zoraizmahmood/Consola-1602-v2/assets/pcb-bottom.png

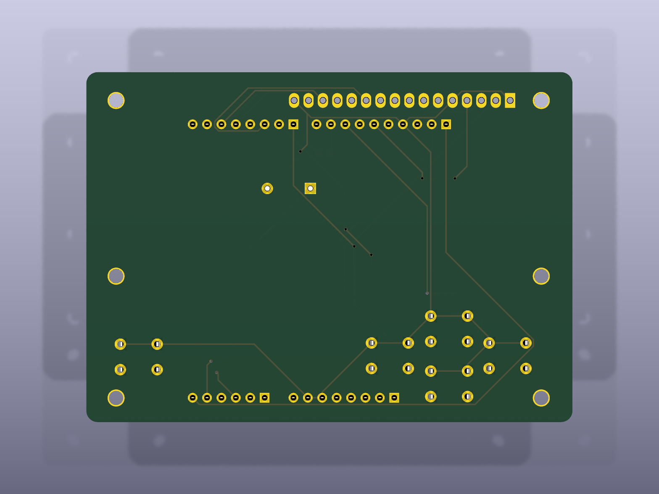
assets/pcb-bottom.png
