zoraizmahmood/Consola-1602-v2/assets/pcb-top.png

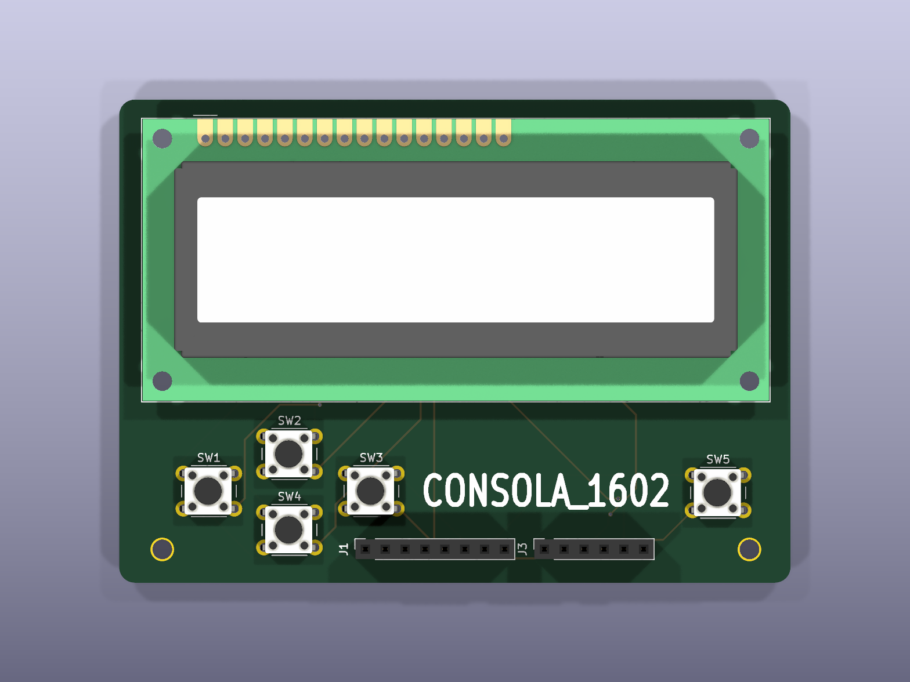
assets/pcb-top.png
