zoraizmahmood/Consola-1602-v2/hardware/carcasa/carcasa-v2.step

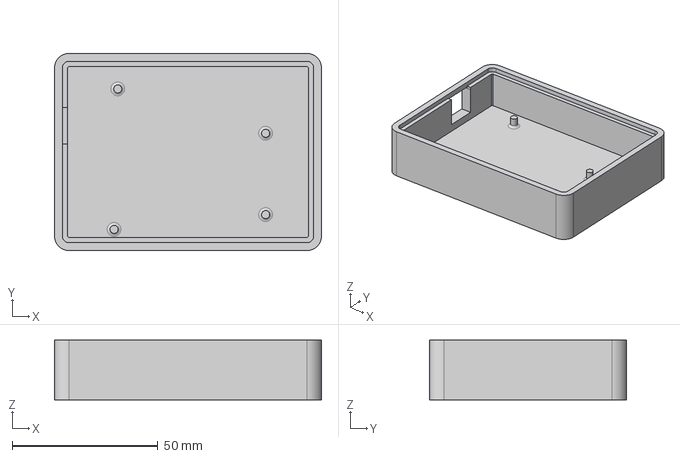
[picture p9: CAD file, 2026-11-06]
hardware/carcasa/carcasa-v2.step
91.7 x 67.8 x 20.6 mm
