zoraizmahmood/Consola-1602-v2/(list of files, cad)

Other CAD files:
hardware/carcasa/carcasa-v2.3mf
