zoraizmahmood/Consola-1602-v2/assets/esquema.pdf

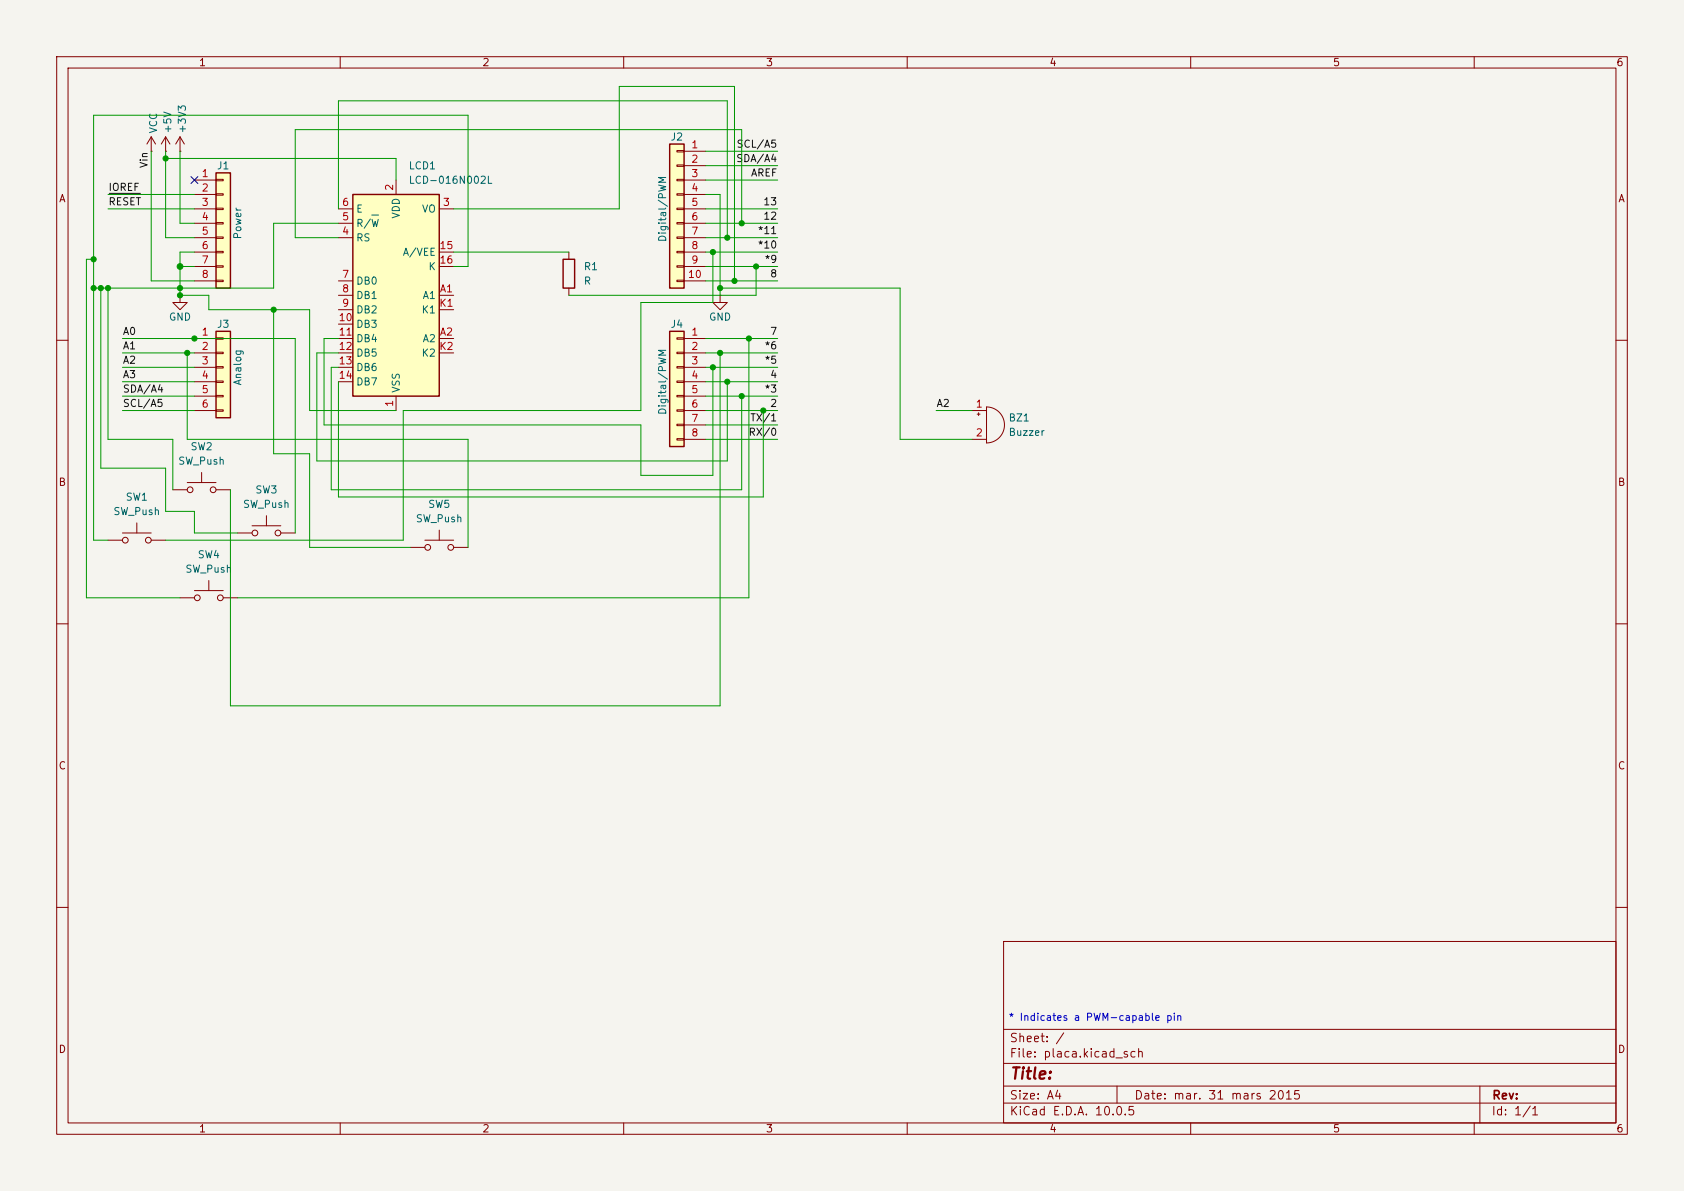
[picture p10: page 1]

* Indicates a PWM-capable pin
Sheet: /
File: placa.kicad_sch
Title:

Size: A4 | Rev:
KiCad E.D.A. 10.0.5 | Id: 1/1
