zoraizmahmood/Consola-1602-v2/hardware/pcb/placa.kicad_pcb

## KiCad design hardware/pcb/placa.kicad_pcb (2026-11-06)

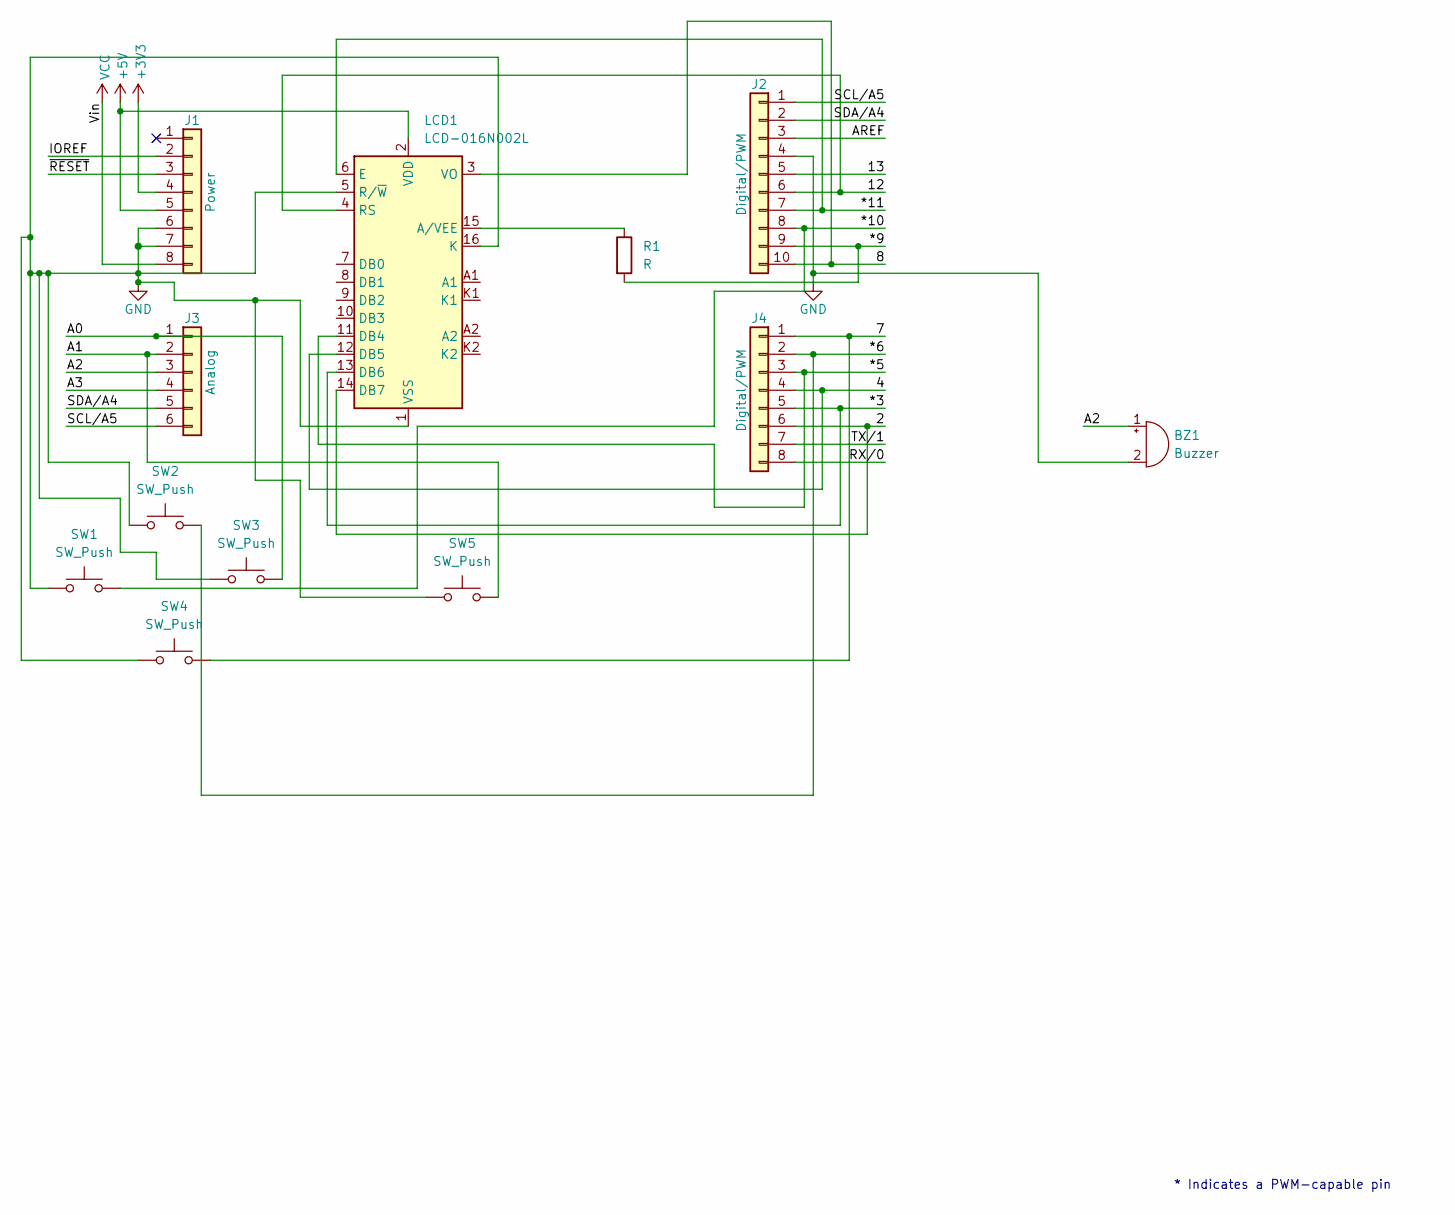
[picture p11: schematic placa.kicad_sch]

Parts:
BZ1: Buzzer; Buzzer_12x9.5RM7.6
J1: Power; PinSocket_1x08_P2.54mm_Vertical
J2: Digital/PWM; PinSocket_1x10_P2.54mm_Vertical
J3: Analog; PinSocket_1x06_P2.54mm_Vertical
J4: Digital/PWM; PinSocket_1x08_P2.54mm_Vertical
LCD1: LCD-016N002L; WC1602A
R1: R; R_0805_2012Metric_Pad1.20x1.40mm_HandSolder
SW1, SW2, SW3, SW4, SW5: SW_Push; SW_PUSH_6mm

Connections:
+3V3: J1.4
+5V: J1.5, LCD1.2 (VDD)
/2: J4.6, LCD1.14 (DB7)
/4: J4.4, LCD1.12 (DB5)
/7: J4.1, SW4.2
/8: J2.10, LCD1.3 (VO)
/12: J2.6, LCD1.4 (RS)
/13: J2.5
/*3: J4.5, LCD1.13 (DB6)
/*5: J4.3, LCD1.11 (DB4)
/*6: J4.2, SW2.2
/*10: J2.8, SW1.2
/*11: J2.7, LCD1.6 (E)
/A0: J3.1, SW3.2
/A1: J3.2, SW5.2
/A2: BZ1.1 (+), J3.3
/A3: J3.4
/AREF: J2.3
/IOREF: J1.2
/RX/0: J4.8
/SCL/A5: J2.1, J3.6
/SDA/A4: J2.2, J3.5
/TX/1: J4.7
/~RESET: J1.3
unnamed: LCD1.15 (A/VEE), R1.1
VCC: J1.8

Notes on the sheet:
* Indicates a PWM-capable pin

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
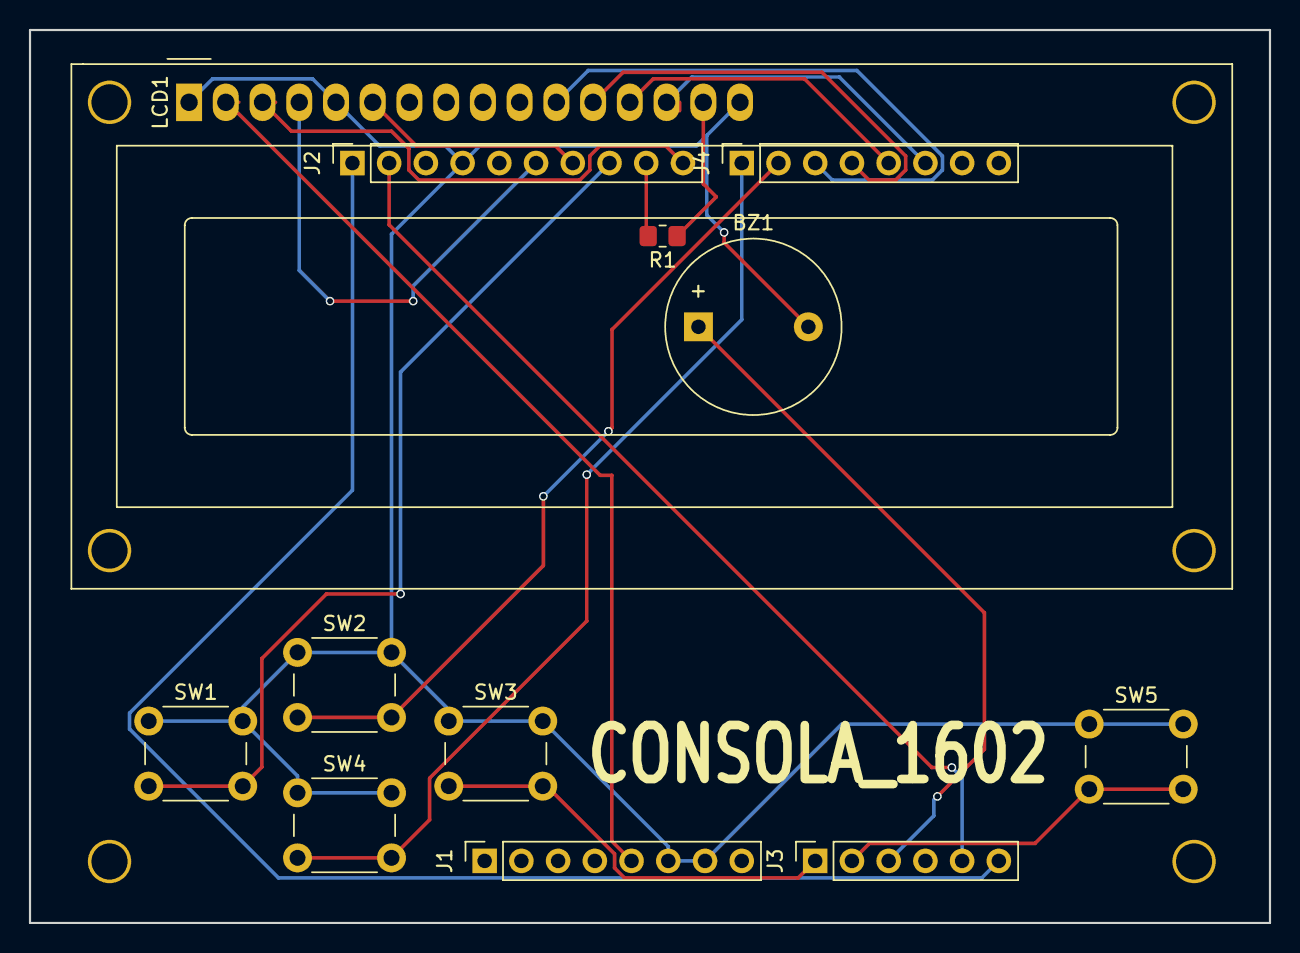
[picture p12: board placa.kicad_pcb from above]

Board: 2 copper layers, 85.8 x 61.8 mm, 12 parts (0 on the bottom side), 19 nets.
