zoraizmahmood/Consola-1602-v2/(commit log)

2026-11-06 Consola 1602 v2: shield PCB fabricado por PCBWay
    - Proyecto KiCad (esquema, placa) y Gerber enviados a PCBWay
    - Renders 3D y esquema en PDF generados con kicad-cli
    - Firmware v2.0 adaptado a la placa: zumbador en A2, V0 del LCD en D8
    - diagram.json de Wokwi actualizado al nuevo cableado
    - README con la experiencia de fabricacion
    [placa-B_Cu.gbr, placa-B_Mask.gbr, placa-B_Silkscreen.gbr, placa-Edge_Cuts.gbr, placa-F_Cu.gbr, placa-F_Mask.gbr, placa-F_Silkscreen.gbr, placa-NPTH.drl]
2026-11-06 Fotos reales de las placas y carcasa v2
    - Fotos de PCBWay recortadas y ajustadas a 1600 px en assets/
    - Carcasa v2 en STEP y 3MF, con render
    - README actualizado con las fotos y la seccion de carcasa
    - Fotos originales (HEIC/DNG) fuera del repo via .gitignore
    [carcasa-v2.3mf, carcasa-v2.step]
2026-11-06 README: experiencia con PCBWay, tiempos y nota sobre la resistencia SMD
